Hashikono/Base-62-Project/Fusion Model/Full model/note.txt

The STL file is too large to place in this repository, you can find it here:
https://drive.google.com/file/d/1EGUreYbUIbTRq8zeVpQEcB6_Y978fLNF/view?usp=sharing

- This is NOT a virus, ping me on github if something goes wrong
- You also found the secret location to the original video (before it was converted into a grainy GIF)
https://drive.google.com/file/d/1DlONbAGfcfhgAQQ5gDxExZBdbgwksNg0/view?usp=sharing
