Hashikono/Base-62-Project/images/example.png

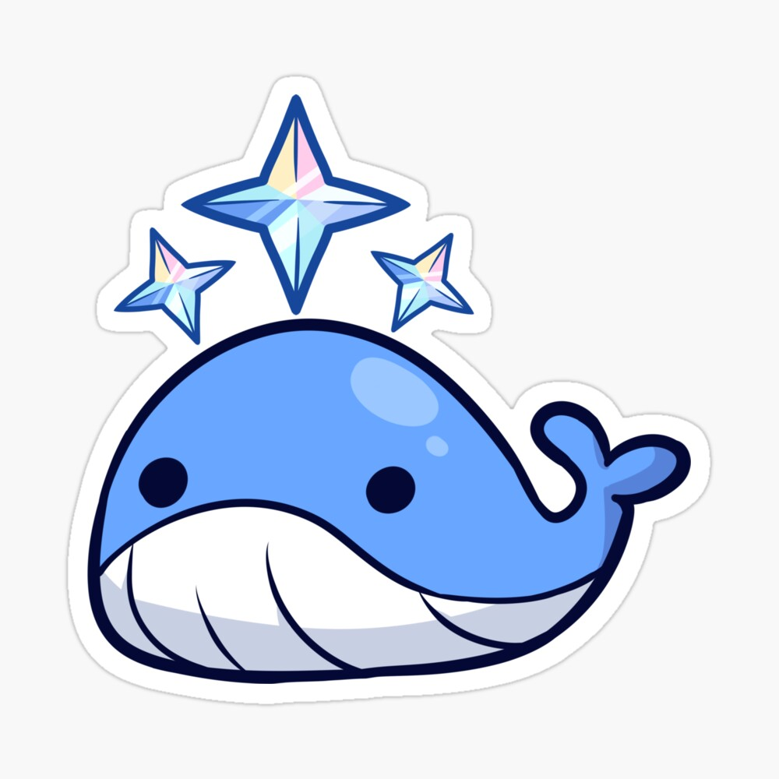
images/example.png
