Hashikono/Base-62-Project/images/スクリーンショット 2026-09-18 234539.png

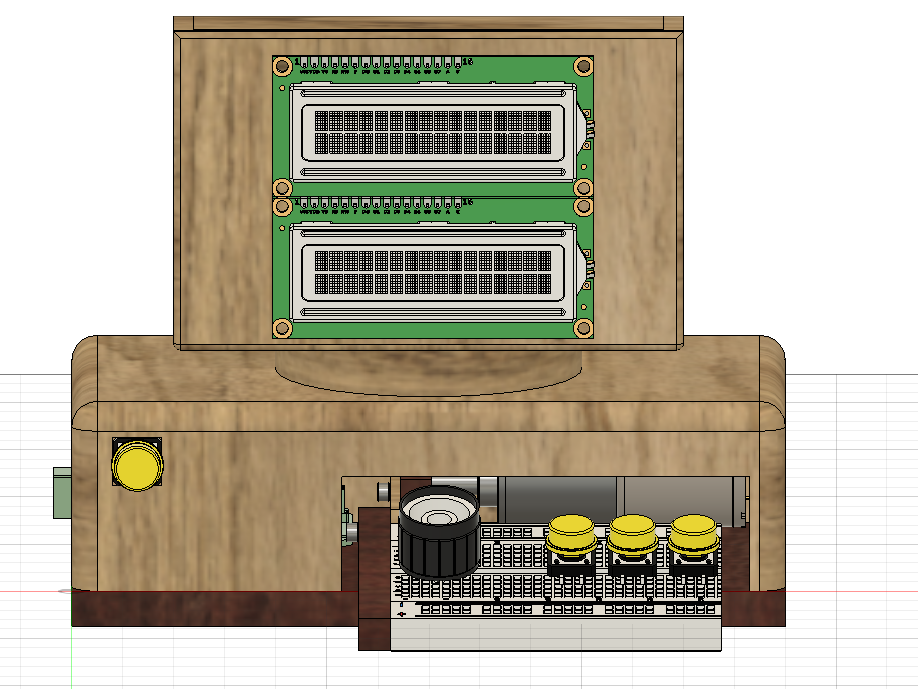
images/スクリーンショット 2026-09-18 234539.png
