Hashikono/Base-62-Project/Fusion Model/3D prints - STL/main pin.stl

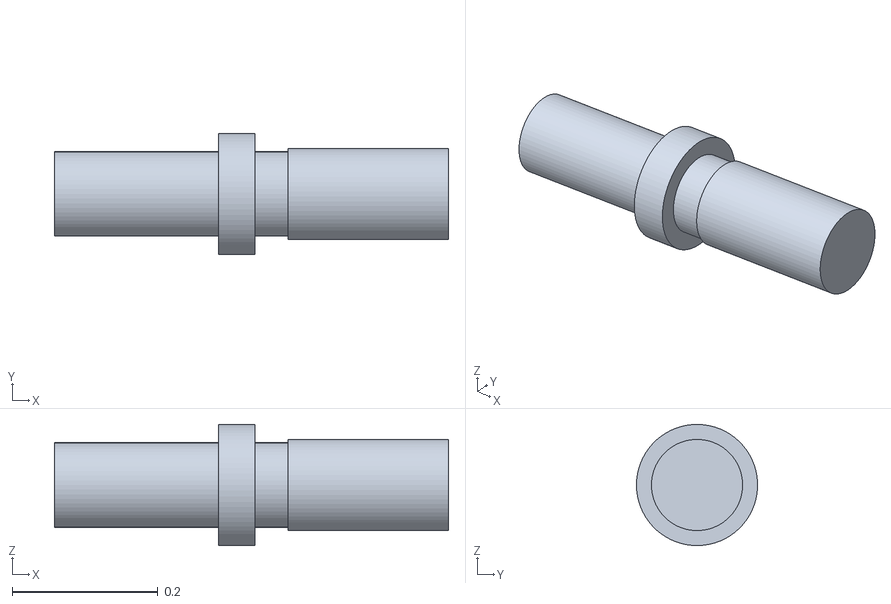
[picture p12: CAD file, 2026-10-22]
Fusion Model/3D prints - STL/main pin.stl
0.54 x 0.166 x 0.166
