Hashikono/Base-62-Project/Fusion Model/3D prints - recommended choice - 3MF/breadboard latch pin.3mf

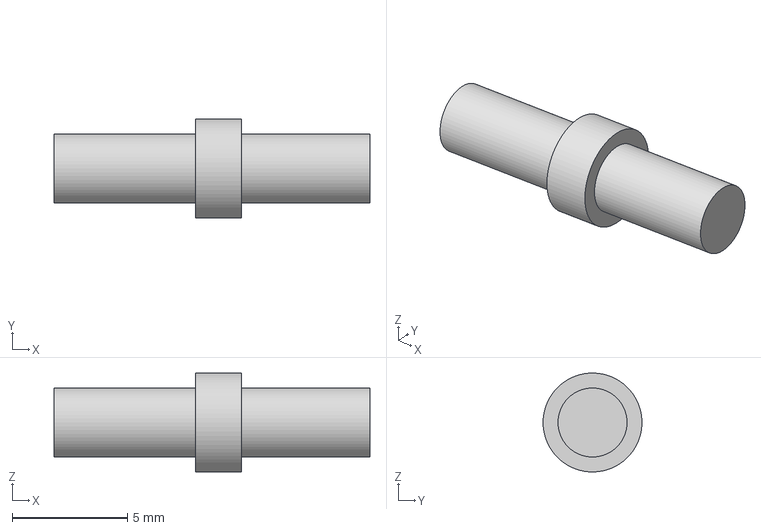
[picture p13: CAD file, 2026-11-12]
Fusion Model/3D prints - recommended choice - 3MF/breadboard latch pin.3mf
13.7 x 4.30 x 4.30 mm
