Hashikono/Base-62-Project/Fusion Model/3D prints - STL/potentiometer knob.stl

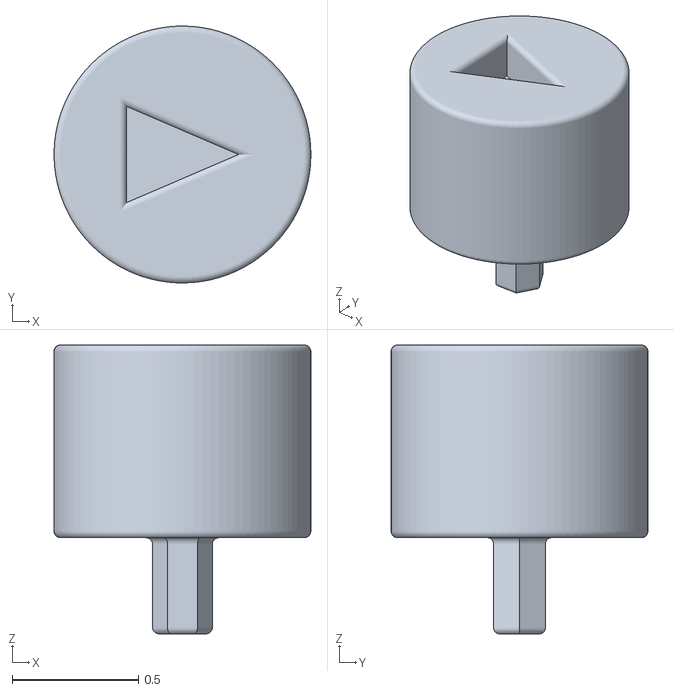
[picture p14: CAD file, 2026-11-08]
Fusion Model/3D prints - STL/potentiometer knob.stl
1.02 x 1.02 x 1.14
