Hashikono/Base-62-Project/Fusion Model/Frames - DXF files/keyboard Left.dxf

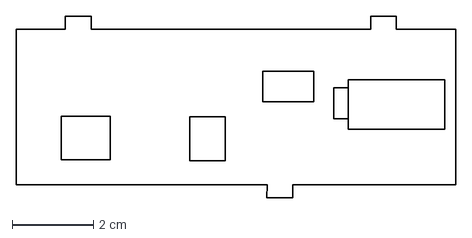
[picture p15: CAD file, 2026-11-08]
Fusion Model/Frames - DXF files/keyboard Left.dxf
10.8 x 4.45 cm
