Hashikono/Base-62-Project/Fusion Model/3D prints - recommended choice - 3MF/potentiometer knob.3mf

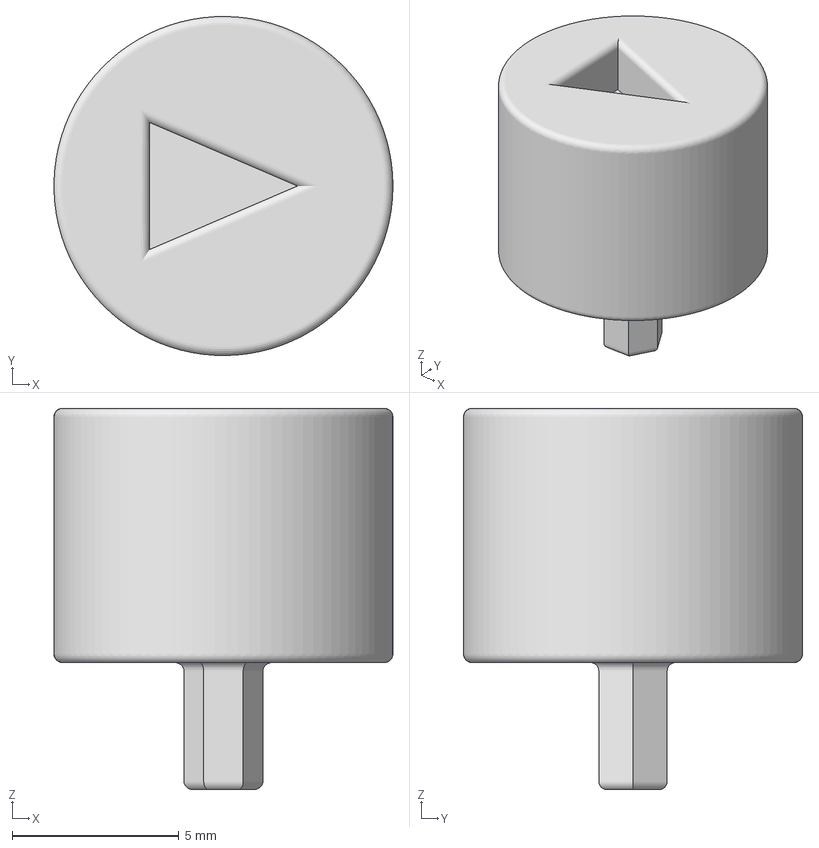
[picture p16: CAD file, 2026-11-12]
Fusion Model/3D prints - recommended choice - 3MF/potentiometer knob.3mf
10.2 x 10.2 x 11.4 mm
