Hashikono/Base-62-Project/Fusion Model/3D prints - STL/breadboard latch ring.stl

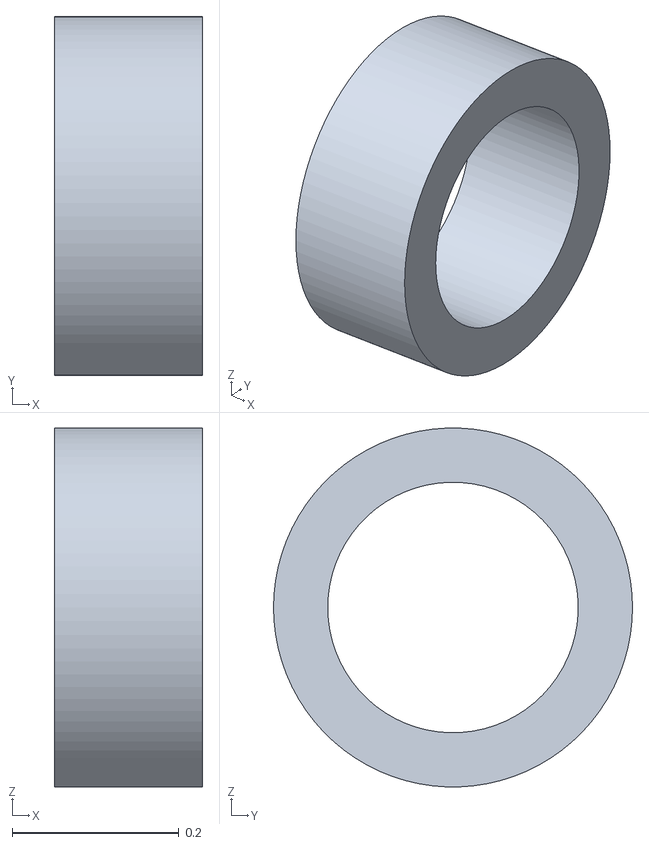
[picture p17: CAD file, 2026-11-08]
Fusion Model/3D prints - STL/breadboard latch ring.stl
0.178 x 0.43 x 0.43
