Hashikono/Base-62-Project/Fusion Model/Frames - DXF files/screen Front.dxf

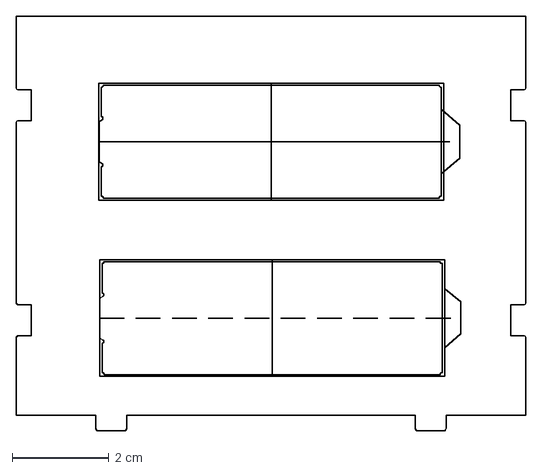
[picture p18: CAD file, 2026-11-08]
Fusion Model/Frames - DXF files/screen Front.dxf
10.5 x 8.57 cm
