Hashikono/Base-62-Project/Fusion Model/3D prints - recommended choice - 3MF/servo motor lever.3mf

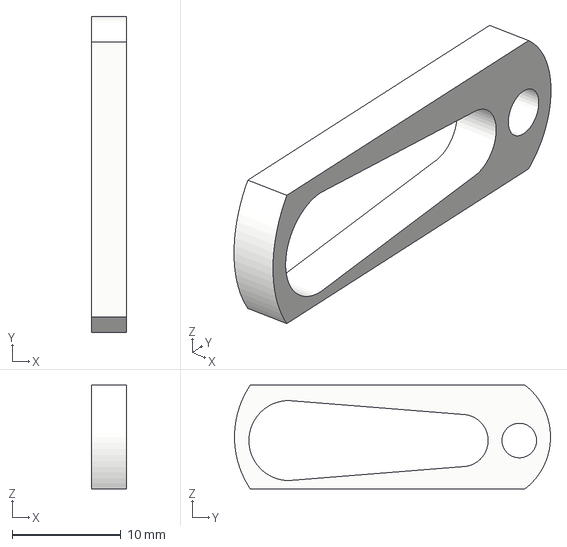
[picture p19: CAD file, 2026-11-12]
Fusion Model/3D prints - recommended choice - 3MF/servo motor lever.3mf
3.18 x 29.0 x 9.51 mm
