Hashikono/Base-62-Project/Fusion Model/3D prints - STL/arduino bracer.stl

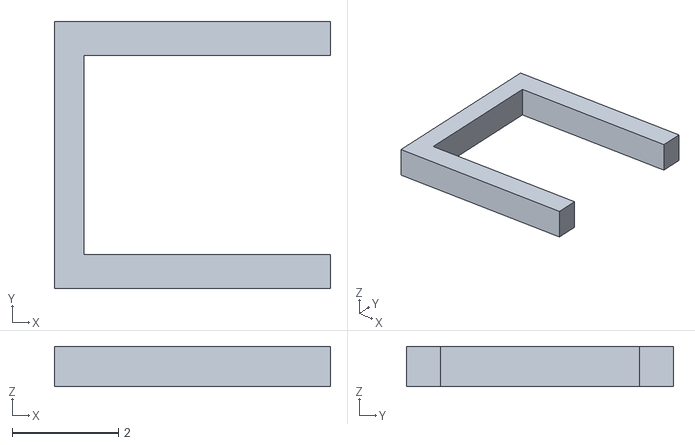
[picture p20: CAD file, 2026-11-08]
Fusion Model/3D prints - STL/arduino bracer.stl
5.19 x 5.02 x 0.762
