Hashikono/Base-62-Project/Fusion Model/Frames - DXF files/screen Lid.dxf

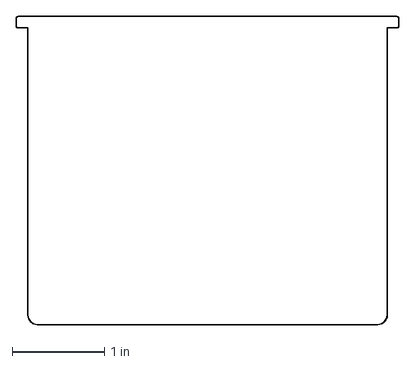
[picture p21: CAD file, 2026-10-22]
Fusion Model/Frames - DXF files/screen Lid.dxf
4.15 x 3.34 in
