Hashikono/Base-62-Project/Fusion Model/3D prints - recommended choice - 3MF/arduino bracer.3mf

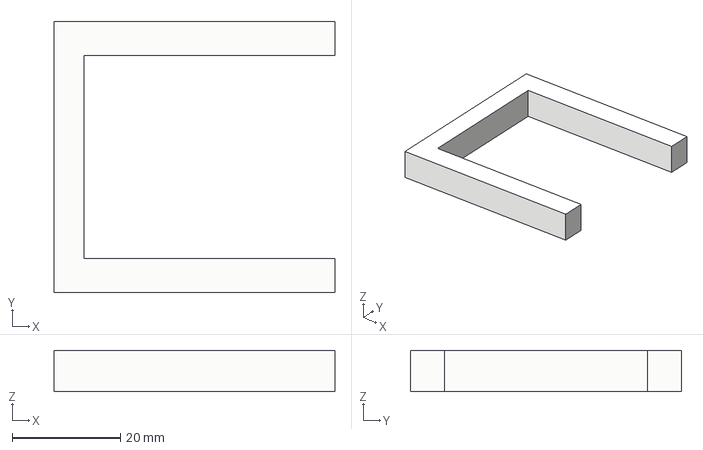
[picture p22: CAD file, 2026-11-12]
Fusion Model/3D prints - recommended choice - 3MF/arduino bracer.3mf
51.9 x 50.2 x 7.62 mm
