Hashikono/Base-62-Project/Fusion Model/3D prints - STL/breadboard latch pin.stl

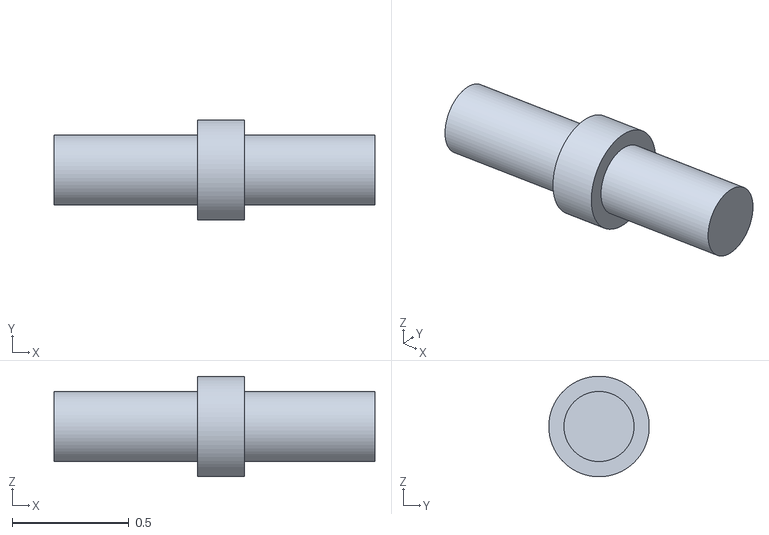
[picture p23: CAD file, 2026-11-08]
Fusion Model/3D prints - STL/breadboard latch pin.stl
1.37 x 0.43 x 0.43
