Hashikono/Base-62-Project/Fusion Model/Frames - DXF files/keyboard Front.dxf

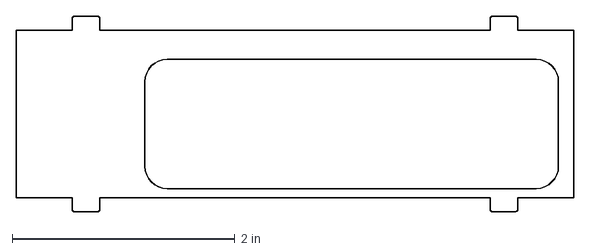
[picture p24: CAD file, 2026-10-22]
Fusion Model/Frames - DXF files/keyboard Front.dxf
5.00 x 1.75 in
