Hashikono/Base-62-Project/Fusion Model/3D prints - recommended choice - 3MF/servo motor bracer.3mf

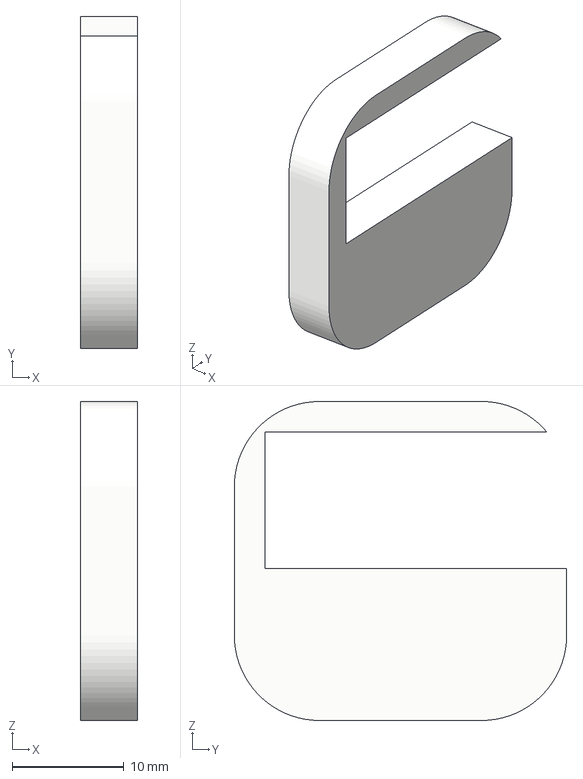
[picture p25: CAD file, 2026-11-12]
Fusion Model/3D prints - recommended choice - 3MF/servo motor bracer.3mf
5.08 x 29.7 x 28.5 mm
