Hashikono/Base-62-Project/Fusion Model/3D prints - STL/breadboard latch.stl

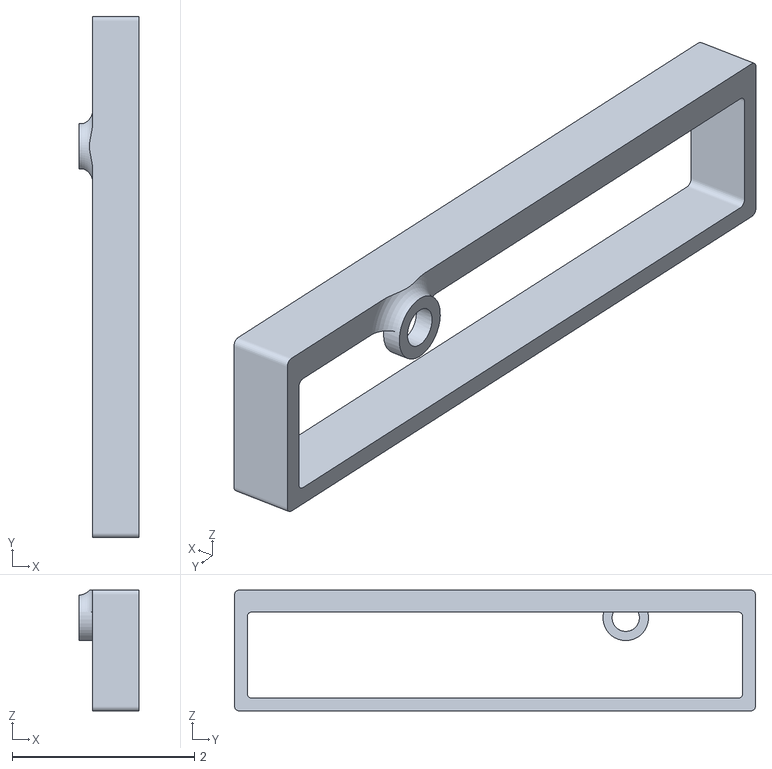
[picture p26: CAD file, 2026-11-08]
Fusion Model/3D prints - STL/breadboard latch.stl
0.658 x 5.71 x 1.32
