Hashikono/Base-62-Project/Fusion Model/Frames - DXF files/screen back.dxf

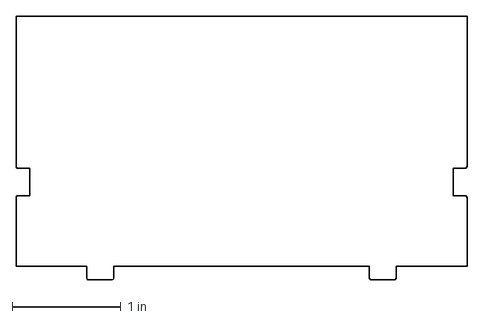
[picture p27: CAD file, 2026-10-22]
Fusion Model/Frames - DXF files/screen back.dxf
4.15 x 2.42 in
