Hashikono/Base-62-Project/Fusion Model/3D prints - recommended choice - 3MF/breadboard latch ring.3mf

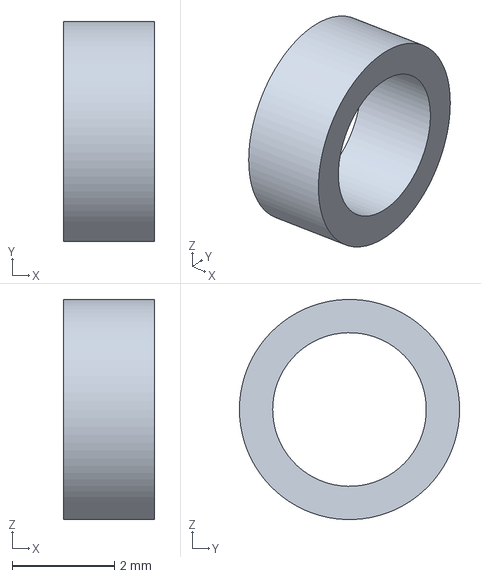
[picture p28: CAD file, 2026-11-12]
Fusion Model/3D prints - recommended choice - 3MF/breadboard latch ring.3mf
1.78 x 4.30 x 4.30 mm
