Hashikono/Base-62-Project/Fusion Model/3D prints - STL/servo motor lever.stl

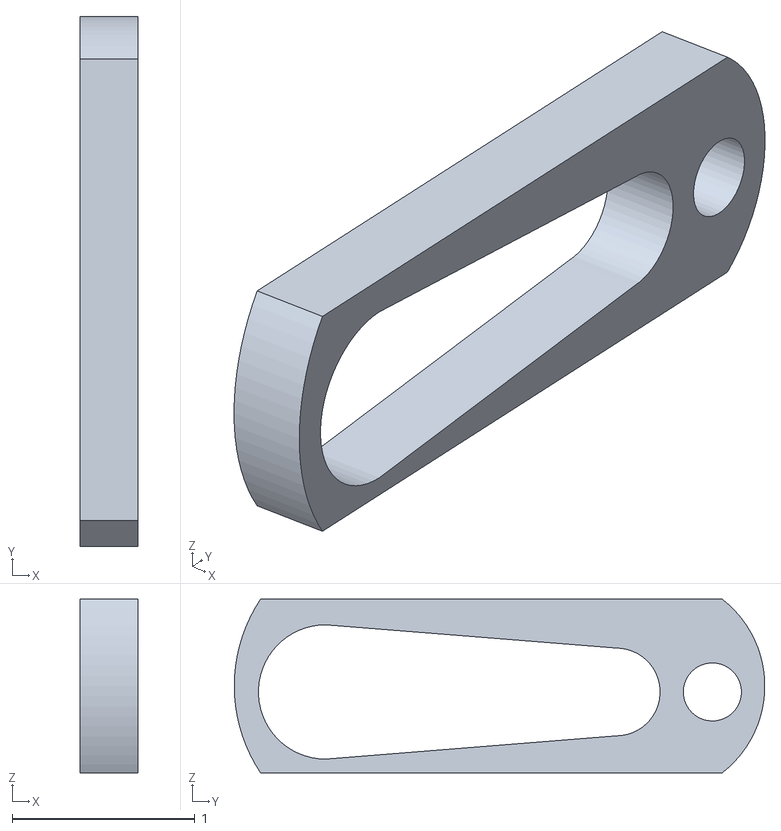
[picture p29: CAD file, 2026-11-08]
Fusion Model/3D prints - STL/servo motor lever.stl
0.318 x 2.90 x 0.951
