Hashikono/Base-62-Project/Fusion Model/Frames - DXF files/keyboard Bottom.dxf

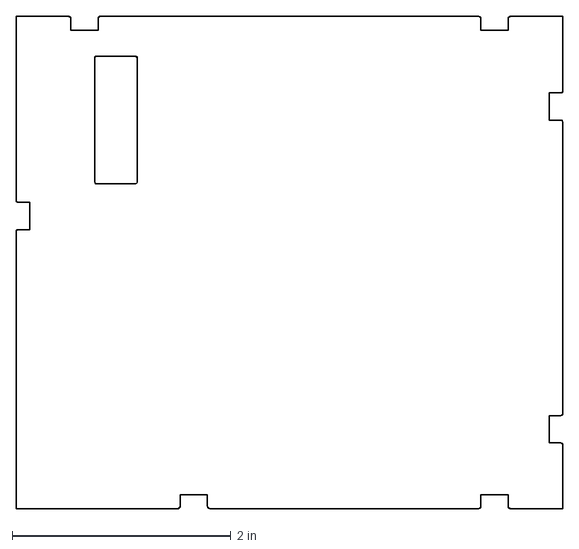
[picture p30: CAD file, 2026-10-22]
Fusion Model/Frames - DXF files/keyboard Bottom.dxf
5.00 x 4.50 in
