Hashikono/Base-62-Project/Fusion Model/3D prints - recommended choice - 3MF/breadboard latch.3mf

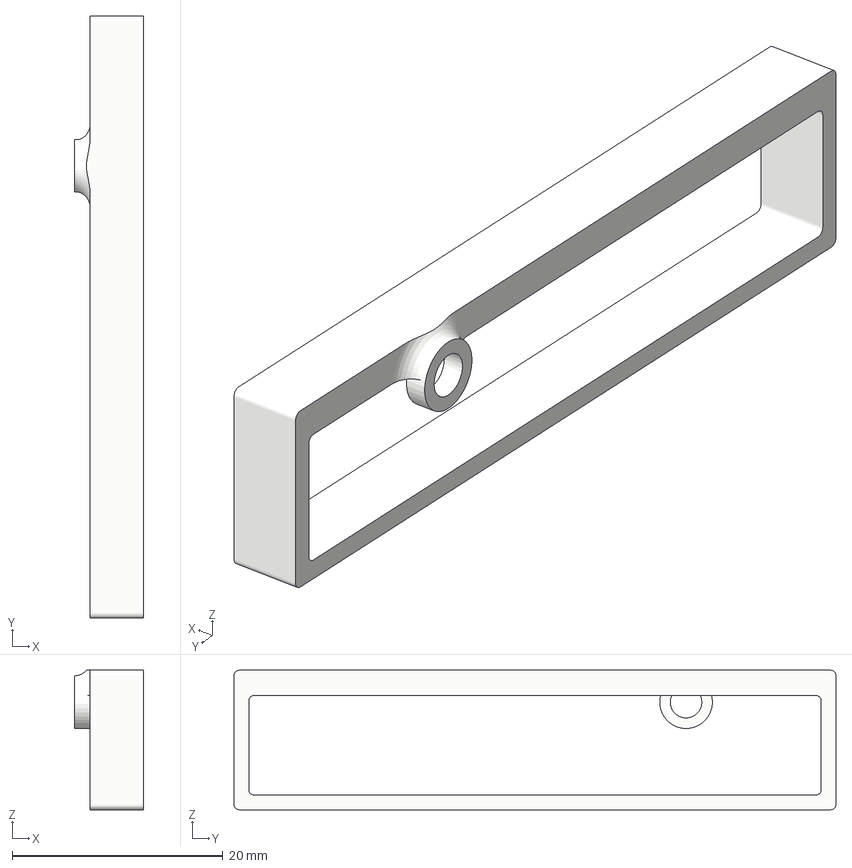
[picture p31: CAD file, 2026-11-12]
Fusion Model/3D prints - recommended choice - 3MF/breadboard latch.3mf
6.58 x 57.1 x 13.2 mm
