Hashikono/Base-62-Project/Fusion Model/3D prints - STL/servo motor bracer.stl

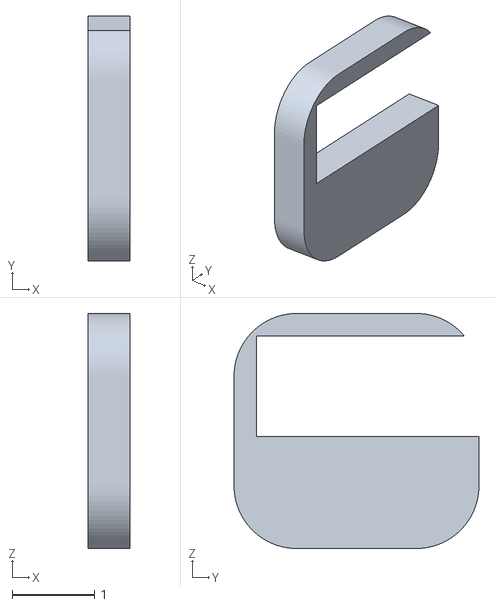
[picture p32: CAD file, 2026-11-08]
Fusion Model/3D prints - STL/servo motor bracer.stl
0.508 x 2.97 x 2.85
