Hashikono/Base-62-Project/Fusion Model/3D prints - STL/motor bracer.stl

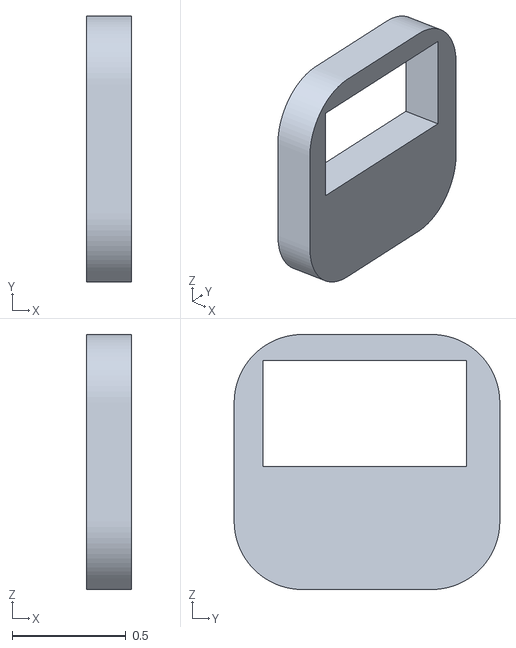
[picture p34: CAD file, 2026-10-22]
Fusion Model/3D prints - STL/motor bracer.stl
0.2 x 1.17 x 1.12
