Hashikono/Base-62-Project/Fusion Model/Frames - DXF files/screen triPanel.dxf

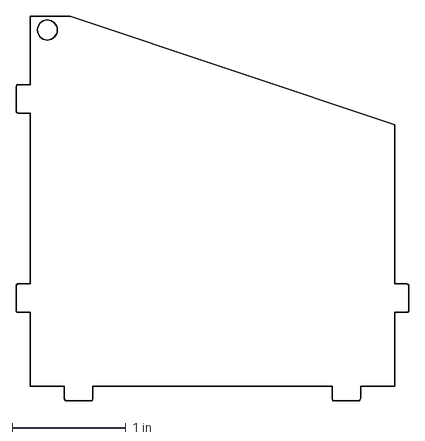
[picture p35: CAD file, 2026-10-22]
Fusion Model/Frames - DXF files/screen triPanel.dxf
3.45 x 3.37 in
