Hashikono/Base-62-Project/Fusion Model/Frames - DXF files/screen anchor2.dxf

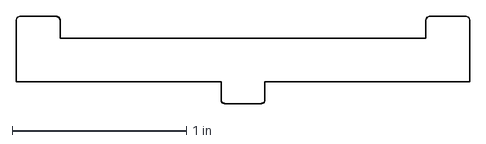
[picture p36: CAD file, 2026-10-22]
Fusion Model/Frames - DXF files/screen anchor2.dxf
2.60 x 0.5 in
