Hashikono/Base-62-Project/Fusion Model/3D prints - STL/motor horn.stl

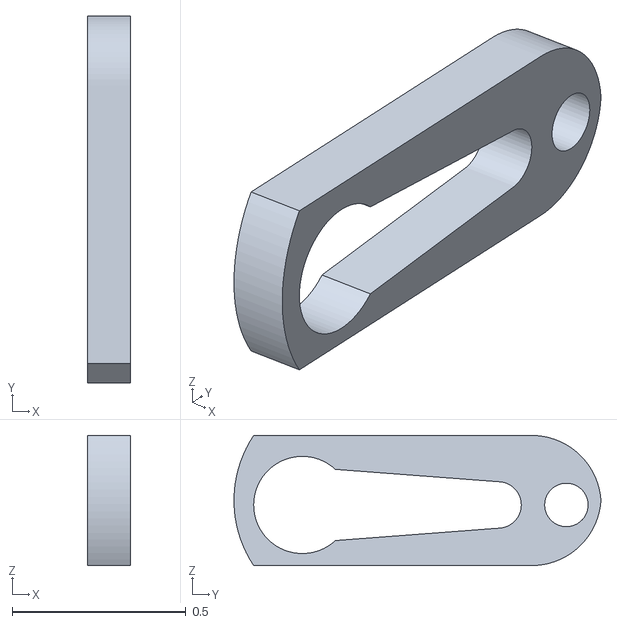
[picture p37: CAD file, 2026-10-22]
Fusion Model/3D prints - STL/motor horn.stl
0.125 x 1.06 x 0.374
