Hashikono/Base-62-Project/Fusion Model/Frames - DXF files/screen Bottom.dxf

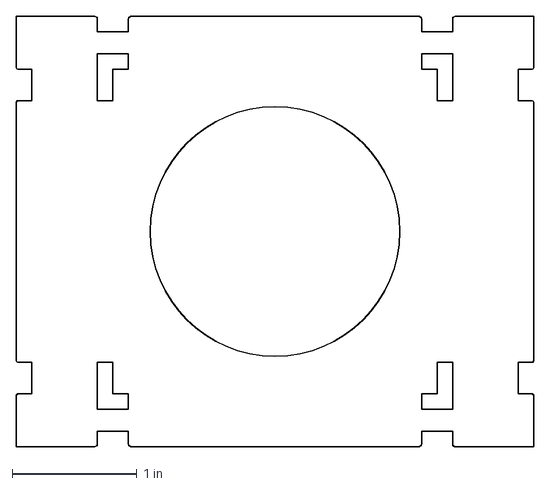
[picture p38: CAD file, 2026-10-22]
Fusion Model/Frames - DXF files/screen Bottom.dxf
4.15 x 3.45 in
