Hashikono/Base-62-Project/Fusion Model/3D prints - STL/breadboard brace.stl

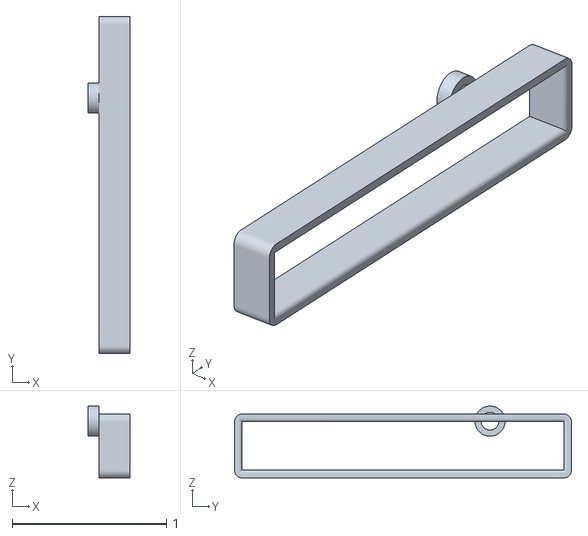
[picture p39: CAD file, 2026-10-22]
Fusion Model/3D prints - STL/breadboard brace.stl
0.273 x 2.19 x 0.466
