Hashikono/Base-62-Project/Fusion Model/Frames - DXF files/Keyboard Right.dxf

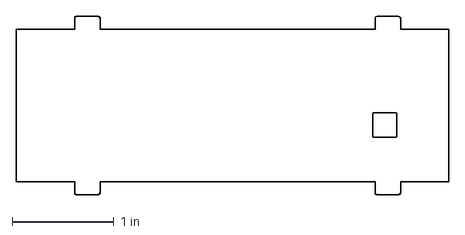
[picture p40: CAD file, 2026-10-22]
Fusion Model/Frames - DXF files/Keyboard Right.dxf
4.25 x 1.75 in
