Hashikono/Base-62-Project/Fusion Model/3D prints - STL/pin end.stl

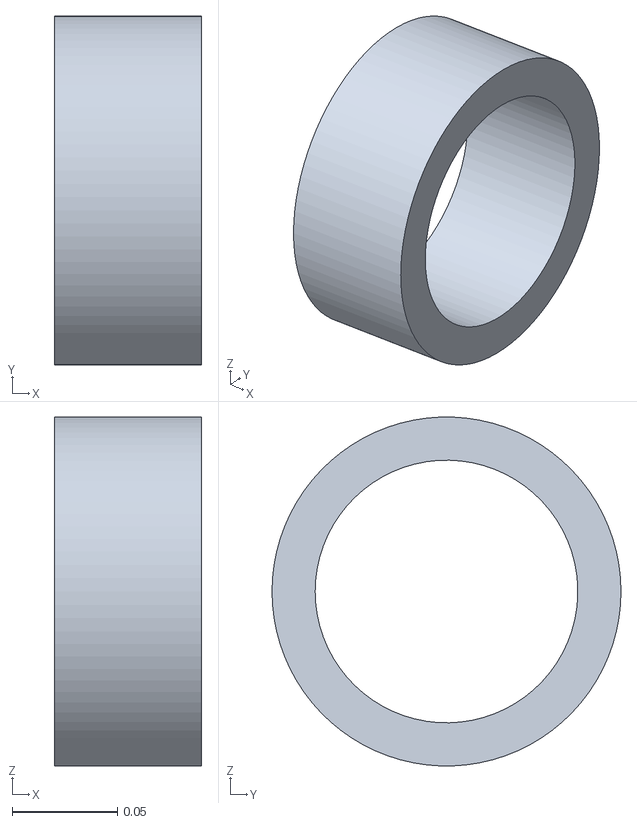
[picture p41: CAD file, 2026-10-22]
Fusion Model/3D prints - STL/pin end.stl
0.07 x 0.166 x 0.166
