Hashikono/Base-62-Project/Fusion Model/Frames - DXF files/keyboard Back.dxf

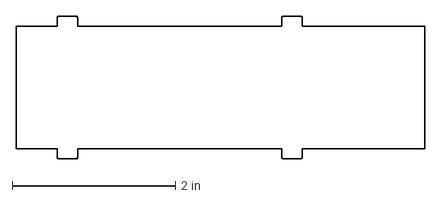
[picture p42: CAD file, 2026-10-22]
Fusion Model/Frames - DXF files/keyboard Back.dxf
5.00 x 1.75 in
