Hashikono/Base-62-Project/Fusion Model/Frames - DXF files/screen anchor1.dxf

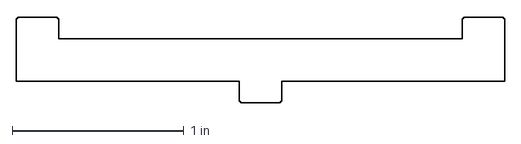
[picture p43: CAD file, 2026-10-22]
Fusion Model/Frames - DXF files/screen anchor1.dxf
2.85 x 0.5 in
