Hashikono/Base-62-Project/(list of files, cad)

Other CAD files:
Fusion Model/Full model - 3MF/Base 62 Parametric Model V3.3mf
Fusion Model/Full model - 3MF/Base 62 Parametric Model V2.3mf
Fusion Model/Full model - 3MF/Base 62 Parametric Model.3mf
