Hashikono/Base-62-Project/Base-62 PURE.cpp

/*//TODO - Hello :>
- You can also make an optional arguement that allows them to input their own set of characters to use
    - Decimal example; instead of 0-9, they can replace it to be A-J
- Make a selection between truncation and rounding
- Add more functions??? (not sure arduino could support it)

- one module on the LCD is always reserved for system
- convert all strings into a list of char to reduce system usage (albeit it does sound stupid)
- program works for possible values that you can input...

- when the user changes bases for inputs, clear their selection so only valid inputs can persist
*/

//arduino compatibility
#include <iostream> //temporary
#include <string.h>
#include <stdint.h>
using namespace std;

//setting definitions
#define MAX_BOOK_LENGTH 62
#define MAX_INPUT_LENGTH 16 //limit to 16 in the LCD
#define MAX_BITS 256 //binary buffer/temp storagfe
#define UNARY_SYM '1'

//derive chars thru list
const char BOOK[] = "0123456789ABCDEFGHIJKLMNOPQRSTUVWXYZabcdefghijklmnopqrstuvwxyz";
const uint8_t BOOK_LENGTH = 62; //gotta love unsigned integers -_-

//finding c index in book
int16_t bookIndex(char c, uint8_t baseLen){
    for(uint8_t i = 0; i < baseLen; i++){
        if (BOOK[i] == c) {
            return (int16_t)i;
        }
    }
    return -1; //error
}


//set bitlength accordingly
uint8_t bitLength(uint8_t bookSize){
    uint8_t bits = 0;
    uint16_t commonCap = 1;
    while (commonCap < bookSize){
        commonCap <<= 1; //shifting left
        bits++;
    }
    return bits++;
}

//SECTION - special cases (in a sense):
//conversions for unary
uint16_t fromUnary(const char* s, char sym = UNARY_SYM){
    uint16_t count = 0;
    for (const char* p = s; *p; p++){
        //iterating through a memory address instead of addressing a string
        if(*p == sym) count ++;
    }
    return count;
}

uint8_t toUnary(uint16_t val, char* output, uint8_t outputSize){
    if (val + 1 > outputSize){
        return 0; //though this should rarely happen...
    }
    for (uint16_t i = 0; i < val; i++){
        output[i] = UNARY_SYM;
    }
    output[val] = '\0'; //sneaky-strings againnn
    return (uint8_t)val;
}


//conversion to binary -> making all o fthsi arduino compatible is killing me
uint8_t toBinary(char c, uint8_t base, char* outputt, uint8_t outputSize){
    //literally just its index...
    int16_t ind = bookIndex(c, base);
    if (ind < 0) {
        return 0; //because stupid unary exists
    }

    //bit length setting
    uint8_t bits = bitLength(base);
    if (bits +1> outputSize){
        return 0;
    }

    for (uint8_t i = 0; i < bits; i++){
        outputt[bits-1-i] = char('0' + (ind & 1)); //AND gates...used only in minecraft
        ind >>= 1; //shifting binary right
    }

    outputt[bits] = '\0'; //sneaky way to make a string
    return bits;
}
//!SECTION
//conversion part 1 through constant division
bool digitsToBaseStr(char* digits, uint16_t digitsLength, uint8_t fromBase, uint8_t toBase, char* output, uint16_t outputSize){
    //get rid of leading 0s - somehting forgotten in the base 2^x system
    uint16_t startingVal = 0;
    while (startingVal < digitsLength && digits[startingVal] == 0){
        startingVal++;
    }
    //rids corresponding 0s
    if (startingVal == digitsLength){
        //check
        if (outputSize < 2){
            return false;
        }
        output[0] = BOOK[0];
        output[1] = '\0'; //ender
        return true;
    }

    //builds resulting num in buffer
    char temp[MAX_BITS];
    uint16_t tempLength = 0;
    uint16_t length = digitsLength - startingVal;
    memmove(digits, digits + startingVal, length);

    while (length > 0){
        uint16_t carry = 0;
        uint16_t convlength = 0;
        for (uint16_t i = 0; i < length; i++){
            //current number calculated from base and builder carries value
            uint16_t current = carry * fromBase + (uint8_t)digits[i];
            uint16_t conv = current/toBase;
            carry = current % toBase;

            //conv repetition
            if (convlength > 0 || conv != 0){
                digits[convlength++] = (char)conv;
            }
        }

        //invalidation check
        if (tempLength >= sizeof(temp)){
            return  false;
        }

        //tempoart filled with carry value
        temp[tempLength++] = BOOK[carry];
        length = convlength;
    }

    //another corpulent checker
    if (tempLength + 1 > outputSize){
        return false;
    }

    //output handling
    for (uint16_t i = 0; i < tempLength; i++){
        output[i] = temp[tempLength - 1 - i];
    }
    output[tempLength] = '\0'; //ender
    return true;
}


//main conversion validation / part 2
bool conversion(const char* x, uint8_t fromBase, uint8_t toBase, char* output, uint16_t outputSize){
    //simpe tests
    if (!x || !*x) return false; //address
    if (fromBase < 1 || toBase < 1) return false; //emptiness
    if (fromBase > BOOK_LENGTH || toBase > BOOK_LENGTH) return false; //corpulent
    //maybe add a valid inut section (probably unecessary though)

    //unary > unary
    if (fromBase == 1 && toBase == 1){
        uint16_t conv = fromUnary(x);
        return toUnary(conv, output, ((uint8_t)outputSize) > 0 || conv == 0);
    }
    
    //unary > arbitrary
    if (fromBase == 1){
        uint16_t conv = fromUnary(x);
        //conversion @ 0
        if (conv == 0){
            //check
            if (outputSize < 2){
                return false;
            }
            output[0] = BOOK[0];
            output[1] = '\0'; //memory end
            return true;
        }

        //temp storage
        char buffer[MAX_BITS];
        uint16_t num = 0;
        while (conv > 0) {
            buffer[num++] = (char)(conv & toBase); //similar val
            conv /= toBase; // constant division
        }
        
        //corpulent output
        if (num + 1 > outputSize){
            return false;
        }
        
        //filling in digits for arbitrary number conversion
        for (uint16_t i = 0; i < num; i++){
            output[i] = BOOK[(uint8_t) buffer[num - 1 - i]];
        }

        output[num] = '\0';
        return true;
    }

    //arbitrary > unary
    if (toBase == 1){
        uint16_t value = 0;
        //iterating digits/1s...
        for (const char* pos = x; *pos; pos++){
            int16_t dig = bookIndex(*pos, fromBase);
            value *= fromBase;
            value += dig;
        }
    }

    //arbitrary > arbitrary
    char digits[MAX_INPUT_LENGTH];
    uint16_t dgLen = 0;
    for (const char* p = x; *p; p++) {
        //max check
        if (dgLen >= MAX_INPUT_LENGTH){
            return false;
        }
        digits[dgLen++] = (char)bookIndex(*p, fromBase); //sequential digit conversion
    }
    return digitsToBaseStr(digits, dgLen, fromBase, toBase, output, outputSize);

}


//main calculation
bool calculation(const char* oper, char* num1, char* num2, uint8_t fromBase1, uint8_t fromBase2, uint8_t toBase, char* output, uint16_t outputSize){
    //validation for operator (just in case something goes wrong)
    if (!oper || oper[0] == '\0' || oper[1] != '\0'){
        return false;
    }
    if (!num1 || !num2 || !output){
        return false;
    }
    if (toBase < 2 || toBase > BOOK_LENGTH){
        return false;
    }
   
    //set to decimal
    char dec1[64], dec2[64];
    if(!conversion(num1, fromBase1, 10, dec1, sizeof(dec1))){
        return false;
    }
    if(!conversion(num2, fromBase2, 10, dec2, sizeof(dec2))){
        return false;
    }

    long dec1P = atol(dec1); //parsing
    long dec2P = atol(dec2);

    //actual calculations
    long result = 0;
    //cases
    switch(oper[0]) {
        case '+': result = dec1P + dec2P; break;
        case '-': result = dec1P - dec2P; break;
        case '*': result = dec1P * dec2P; break;
        case '/': 
            if (dec2P == 0) return false;
            //SECTION - Truncating:
            //result = dec1P / dec2P;
            //!SECTION
            

            //SECTION - Rounding:
            if ((dec1P >= 0) == (dec2P >= 0)){
                result = (dec1P + dec2P/2) / dec2P;
            } else {
                result = (dec1P - dec2P/2) / dec2P;
            }
            //!SECTION

            break;
        default: return false; //if no operator present (technically shouldn't happen unless the code screw up)
    }
    
    //formatting/decimal conversion
    char decimalResult[32];
    {
        char temp[24];
        uint16_t num = 0;
        bool negativity = (result < 0);
        unsigned long unum = negativity ? (unsigned long)(-result) : (unsigned long) (result);

        //unum establishment
        if (unum == 0){
            temp[num++] = '0';
        }
        while (unum > 0){
            temp[num++] = char('0' + (unum % 10)); unum/=10; //truncation
        }

        //position sector
        uint16_t position = 0;
        if (negativity){
            decimalResult[position++] = '-';
        }
        while (num > 0){
            decimalResult[position++] = temp[--num]; //prefix num to avoid indexing errors
        }
        decimalResult[position] = '\0'; //ender [I should play minecraft soon]
    }

    //revert conversion
    if (decimalResult[0] == '-'){
        if (outputSize < 2){ //potential negative 0
            return false;
        }
        output[0] = '-';
        if (!conversion(decimalResult + 1, 10, toBase, output +1, outputSize - 1)){
            return false;
        }
        return true;
    }
    return conversion (decimalResult, 10, toBase, output, outputSize);
}

int main()
{
    char out[64];

    //test 1
    conversion("273", 10, 2, out, sizeof(out)) ;
    cout << "conversion 1: " << out << endl;

    //test 2
    conversion("0572", 8, 50, out, sizeof(out));
    cout << "conversion 2: " << out << endl;

    //test 3
    calculation("/", "10", "3", 10, 10, 10, out, sizeof(out));
    cout << "conversion 3: " << out << endl;

    //test 4
    calculation("*", "101", "FF", 2, 16, 10, out, sizeof(out));
    cout << "conversion 4: " << out << endl;

    return 0;
}
