Hashikono/Base-62-Project/(commit log)

2026-09-12 Imported/fixed code from IRL.ino and established the NOTE anchor system
    [Base-62 Project Tinkercad.ino]
2026-09-16 Add fromDecimal function for base conversion and fix toDecimal documentation
    [Base-62.cpp]
2026-09-16 Add conversion function for base conversion and update bulletin board
2026-09-16 Add calculation function for base operations and error handling
    [Base-62.cpp]
2026-09-16 Add prototype harness for conversion and calculation functions with test cases
2026-09-16 Update bulletin board with design notes on base detection and error handling
    [Base-62.cpp]
2026-09-16 Fix missing newline at end of file in main function
    [Base-62.cpp]
2026-10-09 redid everything in pure, and using pure arduino c++ to make a pure program, so I am pure before I go to sleep...lol, who said sleep
2026-10-09 digitsToBaseString function fix...plus random bug fixes
    [Base-62 PURE.cpp]
2026-10-10 Imported the c++ stuff and revised screen printing method/function
2026-10-11 Screen setting function (for switching)
2026-10-12 Added motor support (I'm wayy too tired and I wanna sleep)
